n0bel/esp8266-UdpTemp/hardware/20150411_175204.jpg

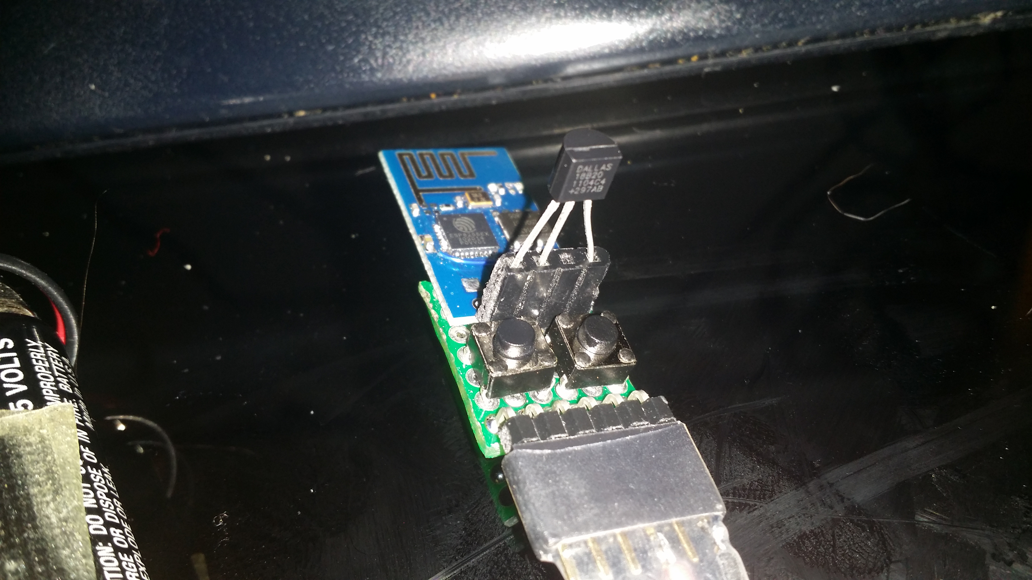
hardware/20150411_175204.jpg
