n0bel/esp8266-UdpTemp/hardware/esp8266-UdpTemp.png

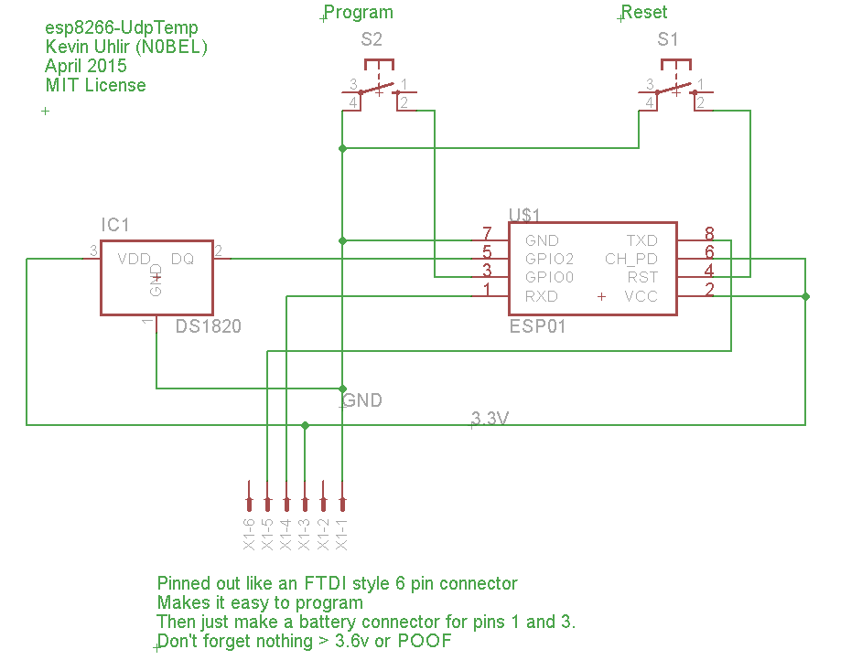
hardware/esp8266-UdpTemp.png
