n0bel/esp8266-UdpTemp/hardware/udptemp-current-analysis2.png

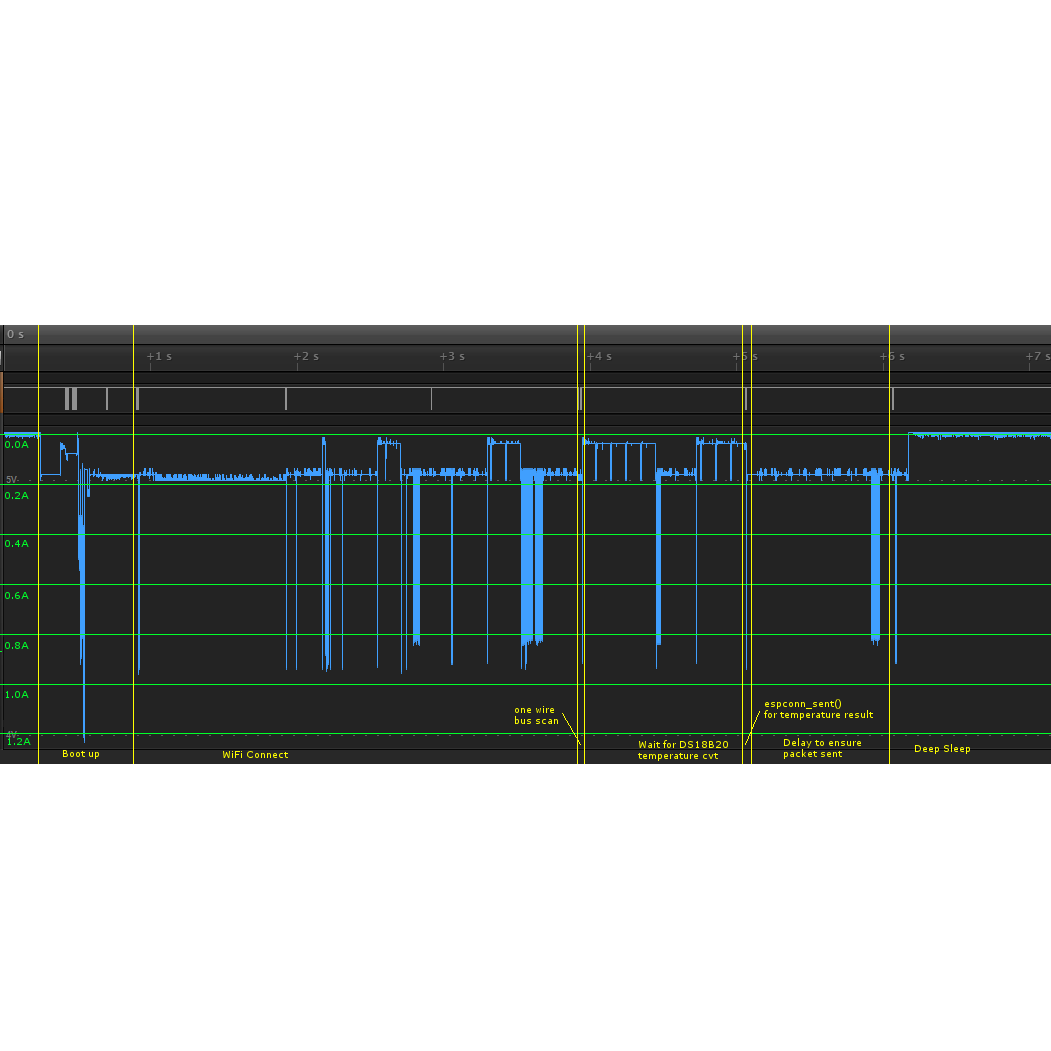
hardware/udptemp-current-analysis2.png
