n0bel/esp8266-UdpTemp/hardware/esp8266-UdpTemp.sch

## EAGLE design hardware/esp8266-UdpTemp.sch (2015-04-18)

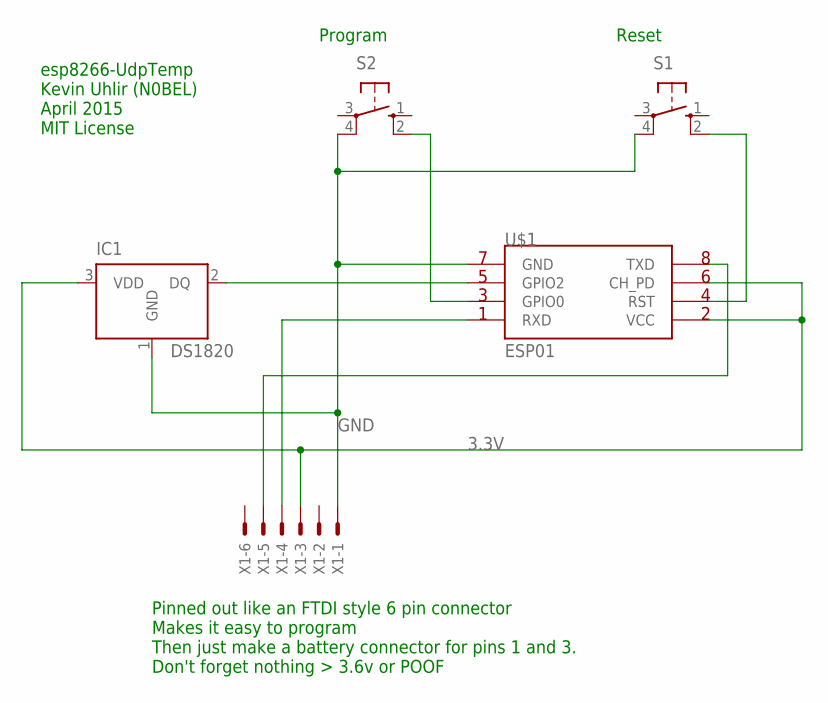
[picture p5: schematic esp8266-UdpTemp.sch]

Parts:
IC1: DS1820; TO-92
S1, S2: 10-XX; B3F-10XX
U$1: ESP01
X1: 22-23-2061

Connections:
3.3V: IC1.3 (VDD), U$1.CH_PD, U$1.VCC, X1.3
GND: IC1.1 (GND), S1.4 (P1), S2.4 (P1), U$1.GND, X1.1
unnamed: IC1.2 (DQ), U$1.GPIO2
unnamed: S2.2 (S1), U$1.GPIO0
unnamed: S1.2 (S1), U$1.RST
RX: U$1.TX (TXD), X1.5
TX: U$1.RX (RXD), X1.4

Notes on the sheet:
Program
Reset
Pinned out like an FTDI style 6 pin connector Makes it easy to program Then just make a battery connector for pins 1 and 3. Don't forget nothing > 3.6v or POOF
esp8266-UdpTemp Kevin Uhlir (N0BEL) April 2015 MIT License
