n0bel/esp8266-UdpTemp/(commit log)

2015-04-18 Added some Hardware docs (schematics, pictures)
    [esp8266-UdpTemp.sch]
2015-04-18 Added current analysis image
2015-04-21 Simplified temperature calculation, includes DS18S20 (0x10) as well as DS18B20 (0x28)
